MoonshineAgency/joint/README.md

# Joint

Project of the MQTT controller based on the ESP32 for horticulture applications.
Contains firmware and KiCad projects for controllers.
