MoonshineAgency/joint/hardware/pH-meter/ph_meter.kicad_pcb

## KiCad design hardware/pH-meter/ph_meter.kicad_pcb (2023-06-20)

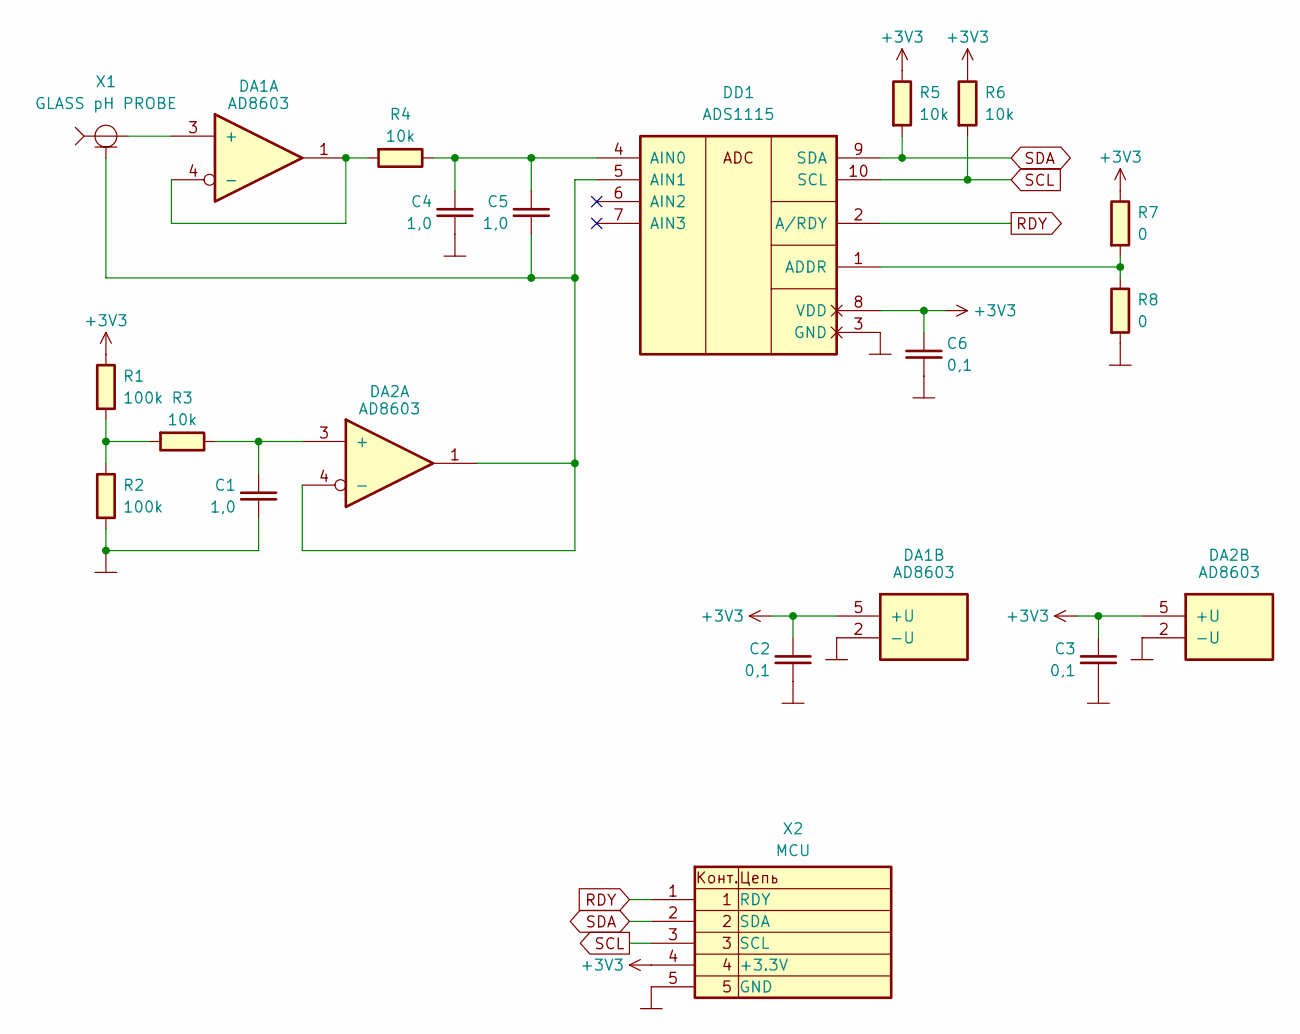
[picture p2: schematic ph_meter.kicad_sch, Digital pH sensor]

Parts:
C1, C4, C5: 1,0; C_0805_2012Metric_Pad1.18x1.45mm_HandSolder
C2, C3, C6: 0,1; C_0805_2012Metric_Pad1.18x1.45mm_HandSolder
DA1, DA2: AD8603; TSOT-23-5_HandSoldering
DD1: ADS1115; MSOP-10_3x3mm_P0.5mm
R1, R2: 100k; R_0805_2012Metric_Pad1.20x1.40mm_HandSolder
R3, R4, R5, R6: 10k; R_0805_2012Metric_Pad1.20x1.40mm_HandSolder
R7, R8: 0; R_0805_2012Metric_Pad1.20x1.40mm_HandSolder
X1: GLASS pH PROBE; BNC_Amphenol_B6252HB-NPP3G-50_Horizontal
X2: MCU; PinHeader_1x05_P2.54mm_Vertical

Connections:
+3V3: C2.2, C3.2, C6.2, DA1.5 (+U), DA2.5 (+U), DD1.8 (VDD), R1.2 (R), R5.2 (R), R6.2 (R), R7.2 (R), X2.4
GND: C1.1, C2.1, C3.1, C4.1, C6.1, DA1.2 (-U), DA2.2 (-U), DD1.3 (GND), R2.1 (L), R8.1 (L), X2.5
unnamed: DA1.3 (+), X1.1
unnamed: DA1.1, DA1.4 (-), R4.1 (L)
unnamed: C1.2, DA2.3 (+), R3.2 (R)
unnamed: C5.1, DA2.1, DA2.4 (-), DD1.5 (AIN1), X1.2
unnamed: DD1.1 (ADDR), R7.1 (L), R8.2 (R)
unnamed: C4.2, C5.2, DD1.4 (AIN0), R4.2 (R)
unnamed: R1.1 (L), R2.2 (R), R3.1 (L)
RDY: DD1.2 (A/RDY), X2.1
SCL: DD1.10 (SCL), R6.1 (L), X2.3
SDA: DD1.9 (SDA), R5.1 (L), X2.2

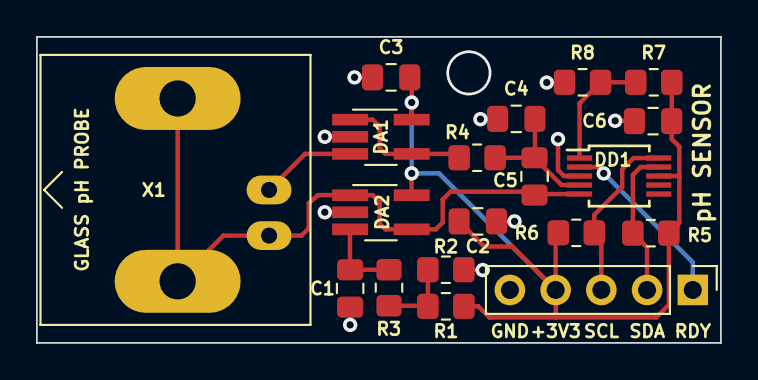
[picture p3: board ph_meter.kicad_pcb from above]

Board: 2 copper layers, 38.0 x 17.0 mm, 19 parts (0 on the bottom side), 12 nets.
