MoonshineAgency/joint/hardware/GH-4DEV/greenhouse.kicad_pcb

## KiCad design hardware/GH-4DEV/greenhouse.kicad_pcb (2023-06-20)

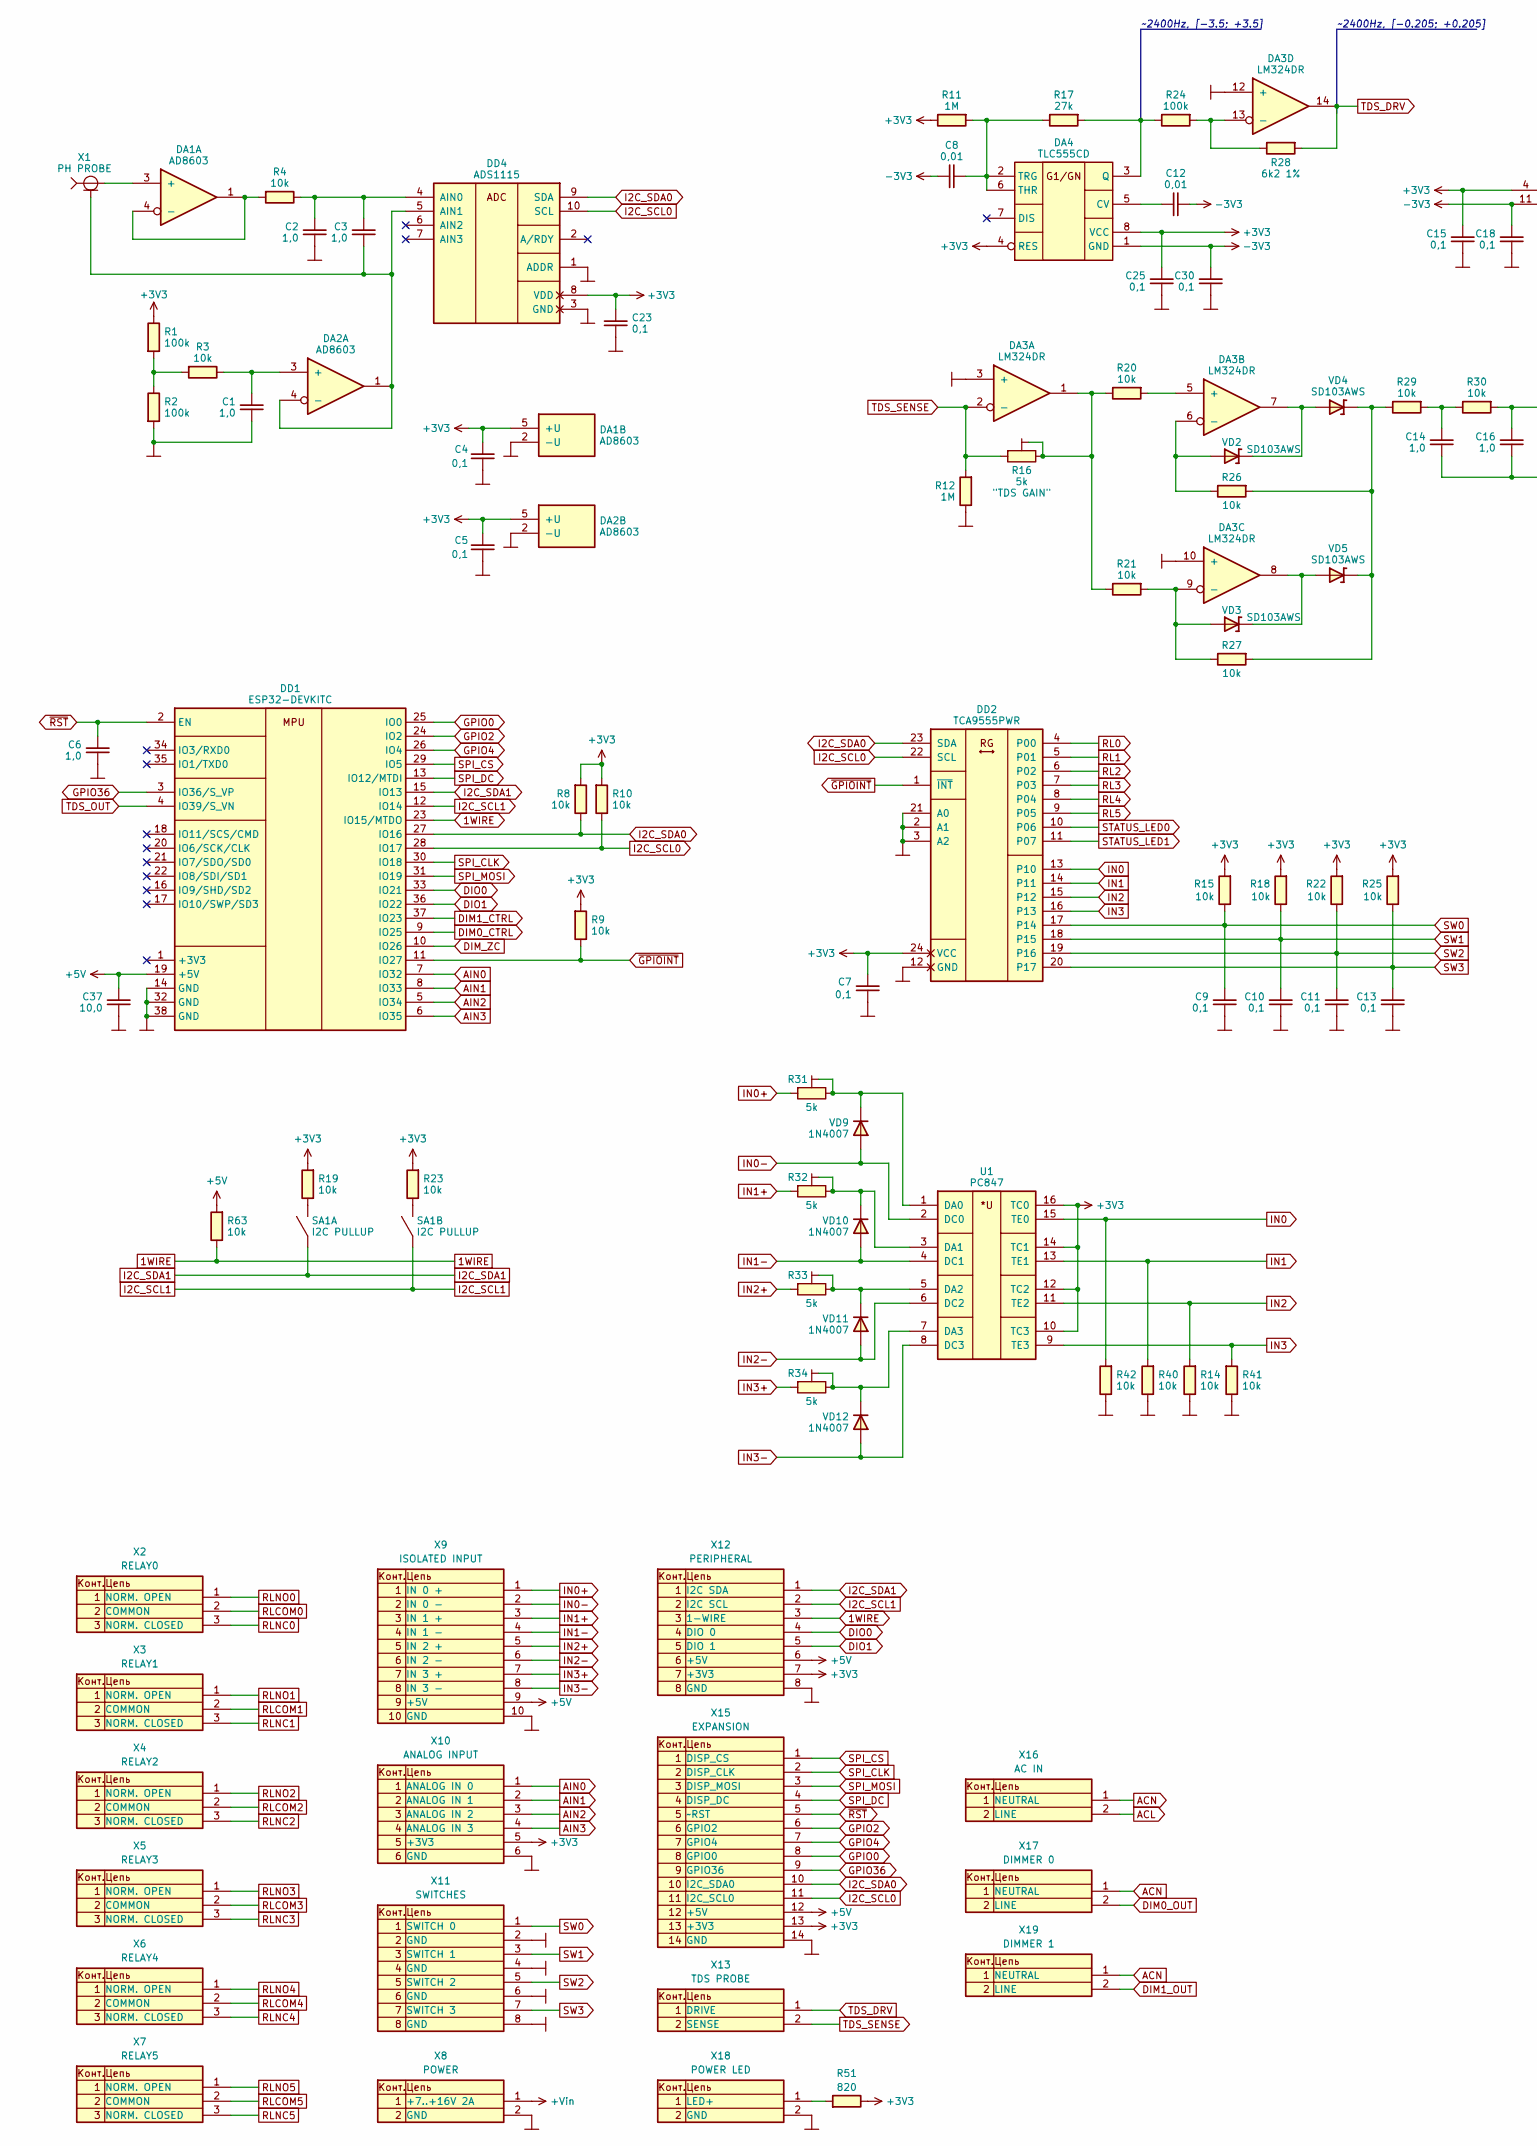
[picture p4: schematic greenhouse.kicad_sch, Greenhouse Controller, part in row 1, column 1]

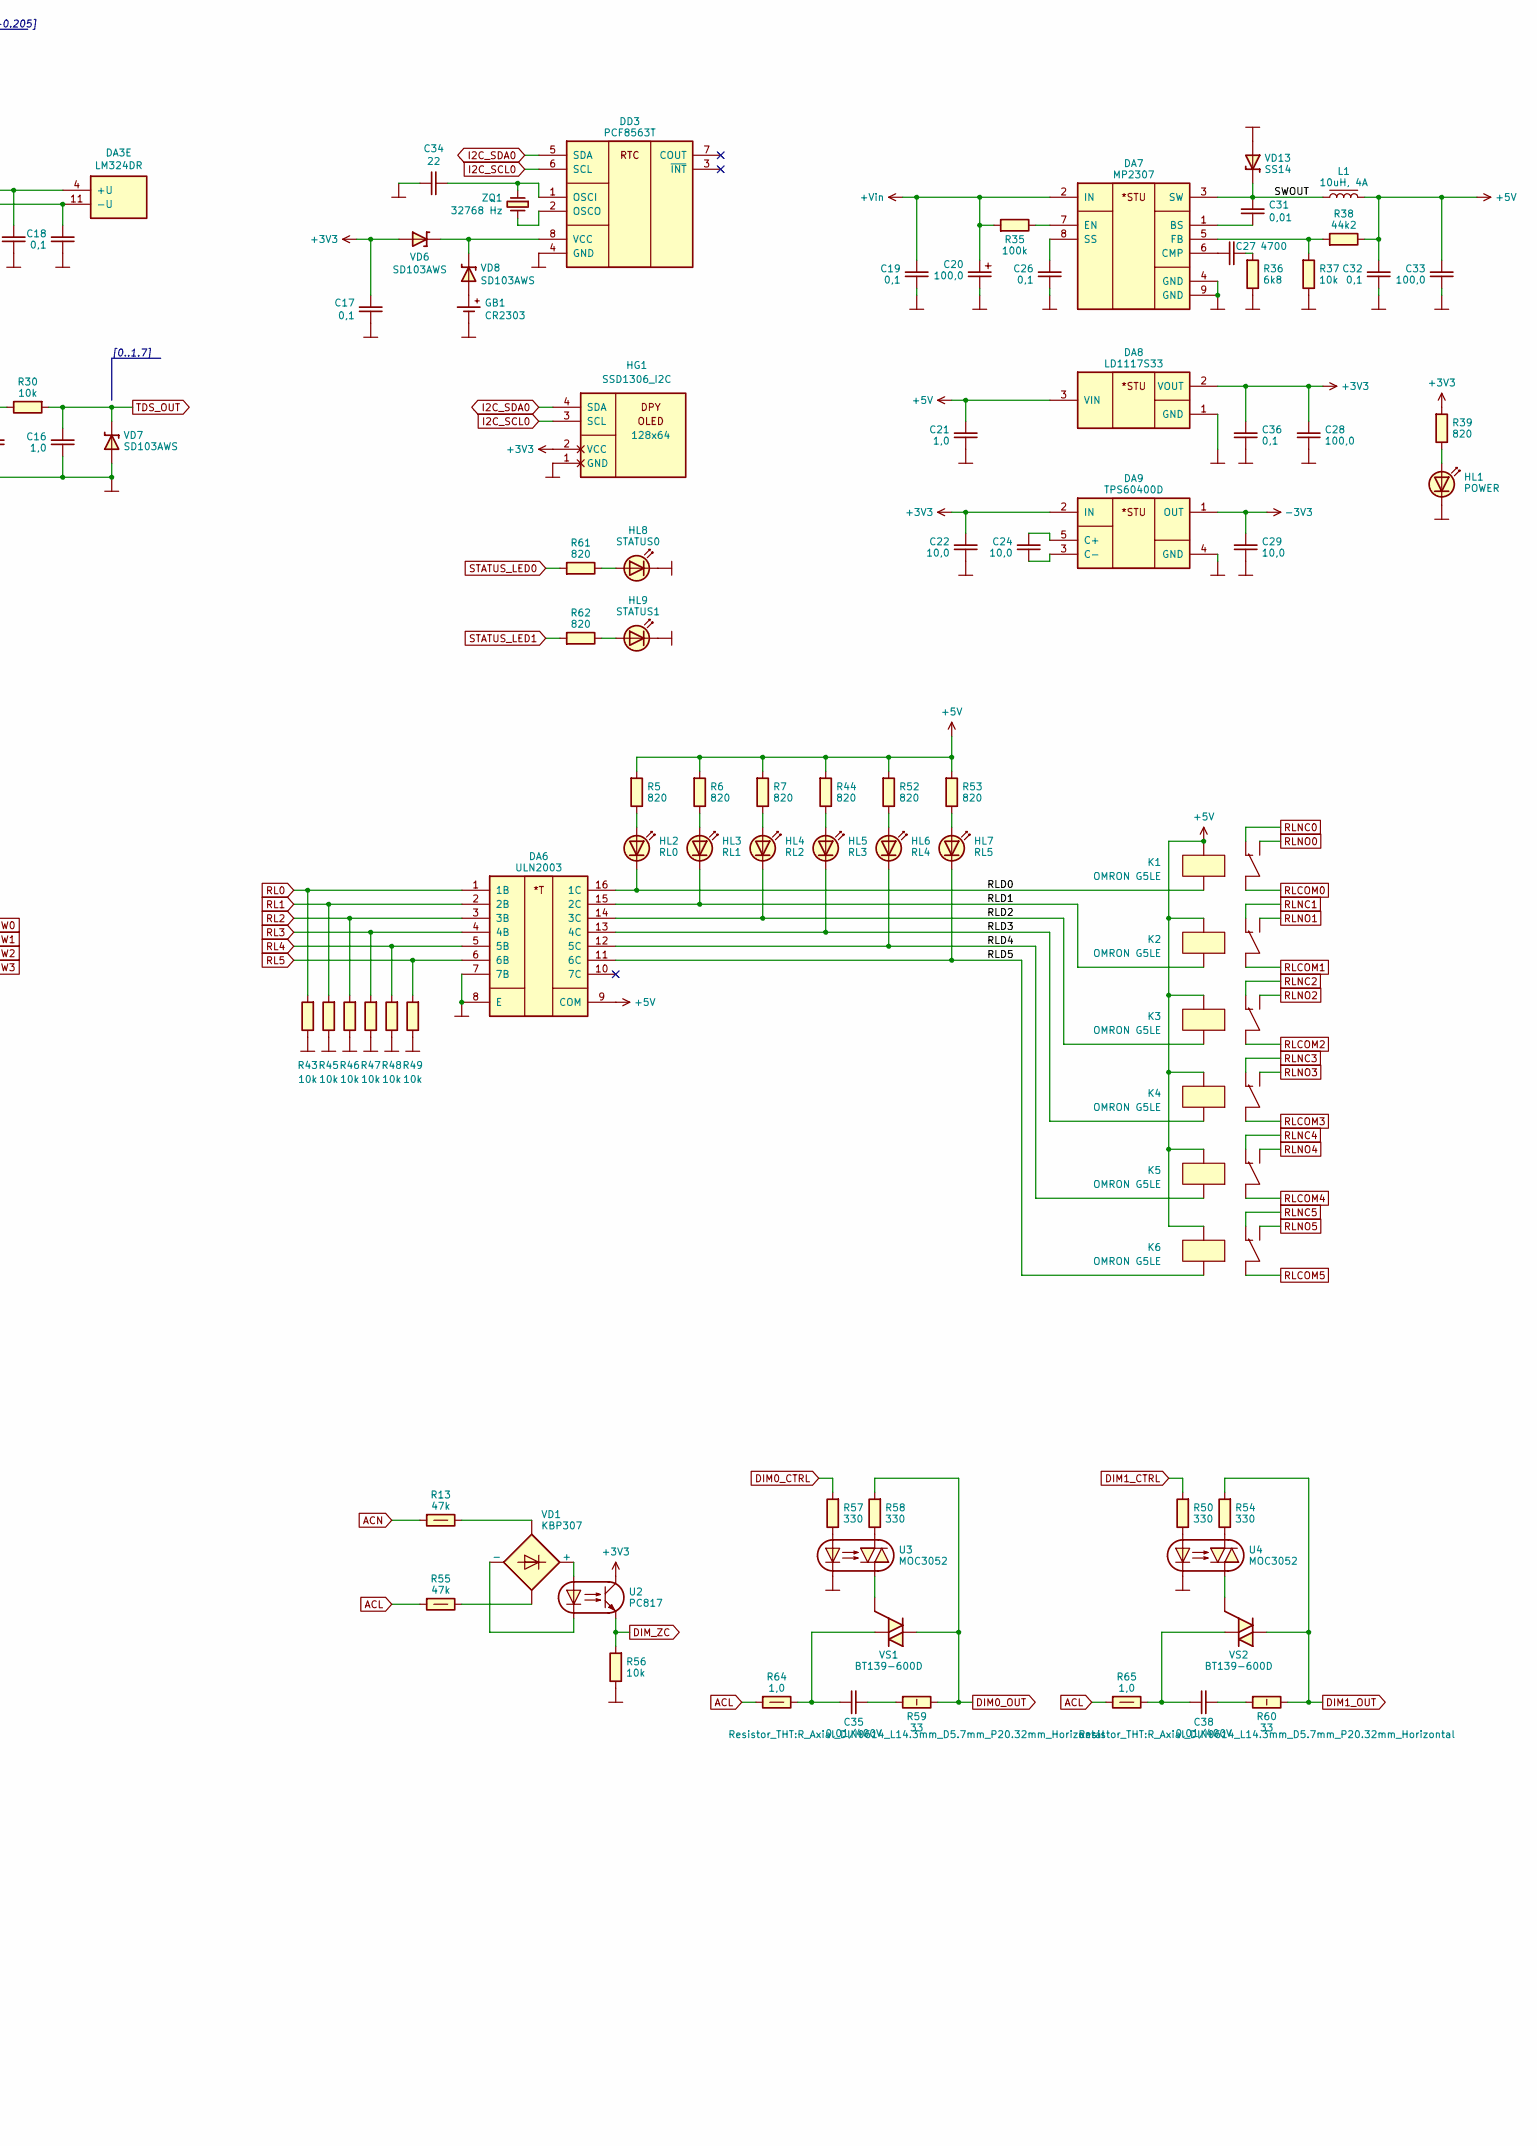
[picture p5: schematic greenhouse.kicad_sch, Greenhouse Controller, part in row 1, column 2]

Parts:
C1, C2, C3, C6, C14, C16, C21: 1,0; C_0805_2012Metric_Pad1.18x1.45mm_HandSolder
C4, C5, C7, C9, C10, C11, C13, C15, C17, C18, C19, C23, C25, C26, C30, C32, C36: 0,1; C_0805_2012Metric_Pad1.18x1.45mm_HandSolder
C8, C12, C31: 0,01; C_0805_2012Metric_Pad1.18x1.45mm_HandSolder
C20: 100,0; CP_EIA-7343-31_Kemet-D_Pad2.25x2.55mm_HandSolder
C22, C24, C29, C37: 10,0; C_0805_2012Metric_Pad1.18x1.45mm_HandSolder
C27: 4700; C_0805_2012Metric_Pad1.18x1.45mm_HandSolder
C28, C33: 100,0; C_1210_3225Metric_Pad1.33x2.70mm_HandSolder
C34: 22; C_0805_2012Metric_Pad1.18x1.45mm_HandSolder
C35, C38: 0,01/400V; C_Rect_L13.0mm_W5.0mm_P10.00mm_FKS3_FKP3_MKS4
DA1, DA2: AD8603; TSOT-23-5_HandSoldering
DA3: LM324DR; SOIC-14_3.9x8.7mm_P1.27mm
DA4: TLC555CD; SOIC-8_3.9x4.9mm_P1.27mm
DA6: ULN2003; SOIC-16_3.9x9.9mm_P1.27mm
DA7: MP2307; HSOP-8-1EP_3.9x4.9mm_P1.27mm_EP2.41x3.1mm_ThermalVias
DA8: LD1117S33; SOT-223-3_TabPin2
DA9: TPS60400D; SOT-23-5_HandSoldering
DD1: ESP32-DEVKITC
DD2: TCA9555PWR; TSSOP-24_4.4x7.8mm_P0.65mm
DD3: PCF8563T; SOIC-8_3.9x4.9mm_P1.27mm
DD4: ADS1115; MSOP-10_3x3mm_P0.5mm
GB1: CR2303; BAT_BS-7
HG1: SSD1306_I2C; SSD1306_0.96_Oled
HL1: POWER; LED_0805_2012Metric_Pad1.15x1.40mm_HandSolder
HL2: RL0; LED_0805_2012Metric_Pad1.15x1.40mm_HandSolder
HL3: RL1; LED_0805_2012Metric_Pad1.15x1.40mm_HandSolder
HL4: RL2; LED_0805_2012Metric_Pad1.15x1.40mm_HandSolder
HL5: RL3; LED_0805_2012Metric_Pad1.15x1.40mm_HandSolder
HL6: RL4; LED_0805_2012Metric_Pad1.15x1.40mm_HandSolder
HL7: RL5; LED_0805_2012Metric_Pad1.15x1.40mm_HandSolder
HL8: STATUS0; LED_0805_2012Metric_Pad1.15x1.40mm_HandSolder
HL9: STATUS1; LED_0805_2012Metric_Pad1.15x1.40mm_HandSolder
K1, K2, K3, K4, K5, K6: OMRON G5LE; Relay_SPDT_Omron-G5LE-1
L1: 10uH, 4A; L_0808
R1, R2, R24, R35: 100k; R_0805_2012Metric_Pad1.20x1.40mm_HandSolder
R3, R4, R8, R9, R10, R14, R15, R18, R19, R20, R21, R22, R23, R25, R26, R27, R29, R30, R37, R40, R41, R42, R43, R45, R46, R47, R48, R49, R56, R63: 10k; R_0805_2012Metric_Pad1.20x1.40mm_HandSolder
R5, R6, R7, R39, R44, R51, R52, R53, R61, R62: 820; R_0805_2012Metric_Pad1.20x1.40mm_HandSolder
R11, R12: 1M; R_0805_2012Metric_Pad1.20x1.40mm_HandSolder
R13, R55: 47k; R_Axial_DIN0309_L9.0mm_D3.2mm_P12.70mm_Horizontal
R16, R31, R32, R33, R34: 5k; Potentiometer_Bourns_3296W_Vertical
R17: 27k; R_0805_2012Metric_Pad1.20x1.40mm_HandSolder
R28: 6k2 1%; R_0805_2012Metric_Pad1.20x1.40mm_HandSolder
R36: 6k8; R_0805_2012Metric_Pad1.20x1.40mm_HandSolder
R38: 44k2; R_0805_2012Metric_Pad1.20x1.40mm_HandSolder
R50, R54, R57, R58: 330; R_0805_2012Metric_Pad1.20x1.40mm_HandSolder
R59, R60: 33; R_Axial_DIN0614_L14.3mm_D5.7mm_P20.32mm_Horizontal
R64, R65: 1,0; R_Axial_DIN0309_L9.0mm_D3.2mm_P2.54mm_Vertical
SA1: I2C PULLUP; SW_DIP_SPSTx02_Slide_6.7x6.64mm_W7.62mm_P2.54mm_LowProfile
U1: PC847; DIP-16_W7.62mm_LongPads
U2: PC817; DIP-4_W7.62mm_LongPads
U3, U4: MOC3052; DIP-6_W7.62mm_LongPads
VD1: KBP307; Diode_Bridge_Vishay_KBPM
VD2, VD3, VD4, VD5, VD6, VD7, VD8: SD103AWS; D_SOD-323_HandSoldering
VD9, VD10, VD11, VD12: 1N4007; D_SOD-123
VD13: SS14; D_SMA
VS1, VS2: BT139-600D; TO-220-3_Vertical
X1: PH PROBE; BNC_Amphenol_B6252HB-NPP3G-50_Horizontal
X2: RELAY0; TerminalBlock_bornier-3_P5.08mm
X3: RELAY1; TerminalBlock_bornier-3_P5.08mm
X4: RELAY2; TerminalBlock_bornier-3_P5.08mm
X5: RELAY3; TerminalBlock_bornier-3_P5.08mm
X6: RELAY4; TerminalBlock_bornier-3_P5.08mm
X7: RELAY5; TerminalBlock_bornier-3_P5.08mm
X8: POWER; TerminalBlock_bornier-2_P5.08mm
X9: ISOLATED INPUT; TerminalBlock_bornier-10_P5.08mm
X10: ANALOG INPUT; TerminalBlock_bornier-6_P5.08mm
X11: SWITCHES; TerminalBlock_bornier-8_P5.08mm
X12: PERIPHERAL; TerminalBlock_bornier-8_P5.08mm
X13: TDS PROBE; TerminalBlock_bornier-2_P5.08mm
X15: EXPANSION; PinHeader_2x07_P2.54mm_Vertical
X16: AC IN; TerminalBlock_bornier-2_P5.08mm
X17: DIMMER 0; TerminalBlock_bornier-2_P5.08mm
X18: POWER LED; PinHeader_1x02_P2.54mm_Vertical
X19: DIMMER 1; TerminalBlock_bornier-2_P5.08mm
ZQ1: 32768 Hz; Crystal_DS26_D2.0mm_L6.0mm_Horizontal

Connections:
1WIRE: DD1.23 (IO15/MTDO), R63.2 (R), X12.3
+3V3: C4.1, C5.1, C7.1, C15.1, C17.1, C22.1, C23.2, C25.1, C28.1, C36.1, DA1.5 (+U), DA2.5 (+U), DA3.4 (+U), DA4.4 (RES), DA4.8 (VCC), DA8.2 (VOUT), DA9.2 (IN), DD2.24 (VCC), DD4.8 (VDD), HG1.2 (VCC), R1.2 (R), R8.1 (L), R9.1 (L), R10.1 (L), R11.2 (R), R15.1 (L), R18.1 (L), R19.1 (L), R22.1 (L), R23.1 (L), R25.1 (L), R39.1 (L), R51.2 (R), U1.10 (TC3), U1.12 (TC2), U1.14 (TC1), U1.16 (TC0), U2.4, VD6.2 (A), X10.5, X12.7, X15.13
+5V: C21.1, C32.1, C33.1, C37.1, DA6.9 (COM), DA8.3 (VIN), DD1.19 (+5V), K1.2, K2.2, K3.2, K4.2, K5.2, K6.2, L1.2, R5.1 (L), R6.1 (L), R7.1 (L), R38.2 (R), R44.1 (L), R52.1 (L), R53.1 (L), R63.1 (L), X9.9, X12.6, X15.12
+Vin: C19.1, C20.1, DA7.2 (IN), R35.1 (L), X8.1
-3V3: C8.2, C12.1, C18.1, C29.1, C30.1, DA3.11 (-U), DA4.1 (GND), DA9.1 (OUT)
/RLD0: DA6.16 (1C), HL2.1 (K), K1.5
/RLD1: DA6.15 (2C), HL3.1 (K), K2.5
/RLD2: DA6.14 (3C), HL4.1 (K), K3.5
/RLD3: DA6.13 (4C), HL5.1 (K), K4.5
/RLD4: DA6.12 (5C), HL6.1 (K), K5.5
/RLD5: DA6.11 (6C), HL7.1 (K), K6.5
/SWOUT: C31.1, DA7.3 (SW), L1.1, VD13.1 (K)
ACL: R55.1 (L), R64.1 (L), R65.1 (L), X16.2
ACN: R13.1 (L), X16.1, X17.1, X19.1
AIN0: DD1.7 (IO32), X10.1
AIN1: DD1.8 (IO33), X10.2
AIN2: DD1.5 (IO34), X10.3
AIN3: DD1.6 (IO35), X10.4
DIM0_CTRL: DD1.9 (IO25), R57.1 (L)
DIM0_OUT: R58.1 (L), R59.2 (R), VS1.2 (A), X17.2
DIM1_CTRL: DD1.37 (IO23), R50.1 (L)
DIM1_OUT: R54.1 (L), R60.2 (R), VS2.2 (A), X19.2
DIM_ZC: DD1.10 (IO26), R56.1 (L), U2.3
DIO0: DD1.33 (IO21), X12.4
DIO1: DD1.36 (IO22), X12.5
GND: C1.1, C2.1, C4.2, C5.2, C6.2, C7.2, C9.2, C10.2, C11.2, C13.2, C14.2, C15.2, C16.2, C17.2, C18.2, C19.2, C20.2, C21.2, C22.2, C23.1, C25.2, C26.2, C28.2, C29.2, C30.2, C32.2, C33.2, C34.2, C36.2, C37.2, DA1.2 (-U), DA2.2 (-U), DA3.3 (+), DA3.10 (+), DA3.12 (+), DA6.7 (7B), DA6.8 (E), DA7.4 (GND), DA7.9 (GND), DA8.1 (GND), DA9.4 (GND), DD1.14 (GND), DD1.32 (GND), DD1.38 (GND), DD2.2 (A1), DD2.3 (A2), DD2.12 (GND), DD2.21 (A0), DD3.4 (GND), DD4.1 (ADDR), DD4.3 (GND), GB1.2, HG1.1 (GND), HL1.1 (K), HL8.1 (K), HL9.1 (K), R2.1 (L), R12.2 (R), R14.2 (R), R36.2 (R), R37.2 (R), R40.2 (R), R41.2 (R), R42.2 (R), R43.2 (R), R45.2 (R), R46.2 (R), R47.2 (R), R48.2 (R), R49.2 (R), R56.2 (R), U3.2, U4.2, VD7.2 (A), VD13.2 (A), X8.2, X9.10, X10.6, X11.2, X11.4, X11.6, X11.8, X12.8, X15.14, X18.2
GPIO0: DD1.25 (IO0), X15.8
GPIO2: DD1.24 (IO2), X15.6
GPIO4: DD1.26 (IO4), X15.7
GPIO36: DD1.3 (IO36/S_VP), X15.9
I2C_SCL0: DD1.28 (IO17), DD2.22 (SCL), DD3.6 (SCL), DD4.10 (SCL), HG1.3 (SCL), R10.2 (R), X15.11
I2C_SCL1: DD1.12 (IO14), SA1.2 (L), X12.2
I2C_SDA0: DD1.27 (IO16), DD2.23 (SDA), DD3.5 (SDA), DD4.9 (SDA), HG1.4 (SDA), R8.2 (R), X15.10
I2C_SDA1: DD1.15 (IO13), SA1.1 (L), X12.1
IN0: DD2.13 (P10), R42.1 (L), U1.15 (TE0)
IN0+: R31.1, X9.1
IN0-: U1.2 (DC0), VD9.2 (A), X9.2
IN1: DD2.14 (P11), R40.1 (L), U1.13 (TE1)
IN1+: R32.1, X9.3
IN1-: U1.4 (DC1), VD10.2 (A), X9.4
IN2: DD2.15 (P12), R14.1 (L), U1.11 (TE2)
IN2+: R33.1, X9.5
IN2-: U1.6 (DC2), VD11.2 (A), X9.6
IN3: DD2.16 (P13), R41.1 (L), U1.9 (TE3)
IN3+: R34.1, X9.7
IN3-: U1.8 (DC3), VD12.2 (A), X9.8
unnamed: DA1.3 (+), X1.1
unnamed: DA1.1, DA1.4 (-), R4.1 (L)
unnamed: C1.2, DA2.3 (+), R3.2 (R)
unnamed: C3.1, DA2.1, DA2.4 (-), DD4.5 (AIN1), X1.2
unnamed: DA3.5 (+), R20.1 (L)
unnamed: DA3.6 (-), R26.2 (R), VD2.2 (A)
unnamed: DA3.9 (-), R21.1 (L), R27.2 (R), VD3.2 (A)
unnamed: DA3.13 (-), R24.1 (L), R28.2 (R)
unnamed: C12.2, DA4.5 (CV)
unnamed: DA4.3 (Q), R17.1 (L), R24.2 (R)
unnamed: C8.1, DA4.2 (TRG), DA4.6 (THR), R11.1 (L), R17.2 (R)
unnamed: C31.2, DA7.1 (BS)
unnamed: C27.2, DA7.6 (CMP)
unnamed: DA7.7 (EN), R35.2 (R)
unnamed: DA7.5 (FB), R37.1 (L), R38.1 (L)
unnamed: C26.1, DA7.8 (SS)
unnamed: C24.1, DA9.5 (C+)
unnamed: C24.2, DA9.3 (C-)
unnamed: C34.1, DD3.1 (OSCI), ZQ1.1
unnamed: DD3.2 (OSCO), ZQ1.2
unnamed: DD3.8 (VCC), VD6.1 (K), VD8.1 (K)
unnamed: C2.2, C3.2, DD4.4 (AIN0), R4.2 (R)
unnamed: HL1.2 (A), R39.2 (R)
unnamed: HL2.2 (A), R5.2 (R)
unnamed: HL3.2 (A), R6.2 (R)
unnamed: HL4.2 (A), R7.2 (R)
unnamed: HL5.2 (A), R44.2 (R)
unnamed: HL6.2 (A), R52.2 (R)
unnamed: HL7.2 (A), R53.2 (R)
unnamed: HL8.2 (A), R61.2 (R)
unnamed: HL9.2 (A), R62.2 (R)
unnamed: R1.1 (L), R2.2 (R), R3.1 (L)
unnamed: R13.2 (R), VD1.2
unnamed: R19.2 (R), SA1.4 (R)
unnamed: DA3.1, R16.2, R16.3, R20.2 (R), R21.2 (R)
unnamed: R23.2 (R), SA1.3 (R)
unnamed: R26.1 (L), R27.1 (L), R29.2 (R), VD4.1 (K), VD5.1 (K)
unnamed: C14.1, R29.1 (L), R30.2 (R)
unnamed: C27.1, R36.1 (L)
unnamed: R50.2 (R), U4.1
unnamed: R51.1 (L), X18.1
unnamed: R54.2 (R), U4.6
unnamed: R55.2 (R), VD1.3
unnamed: R57.2 (R), U3.1
unnamed: R58.2 (R), U3.6
unnamed: C35.2, R59.1 (L)
unnamed: C38.2, R60.1 (L)
unnamed: C35.1, R64.2 (R), VS1.1 (K)
unnamed: C38.1, R65.2 (R), VS2.1 (K)
unnamed: R31.2, R31.3, U1.1 (DA0), VD9.1 (K)
unnamed: R32.2, R32.3, U1.3 (DA1), VD10.1 (K)
unnamed: R33.2, R33.3, U1.5 (DA2), VD11.1 (K)
unnamed: R34.2, R34.3, U1.7 (DA3), VD12.1 (K)
unnamed: U2.1, VD1.1 (+)
unnamed: U2.2, VD1.4 (-)
unnamed: DA3.7, VD2.1 (K), VD4.2 (A)
unnamed: DA3.8, VD3.1 (K), VD5.2 (A)
unnamed: GB1.1, VD8.2 (A)
unnamed: U3.4, VS1.3 (G)
unnamed: U4.4, VS2.3 (G)
RL0: DA6.1 (1B), DD2.4 (P00), R43.1 (L)
RL1: DA6.2 (2B), DD2.5 (P01), R45.1 (L)
RL2: DA6.3 (3B), DD2.6 (P02), R46.1 (L)
RL3: DA6.4 (4B), DD2.7 (P03), R47.1 (L)
RL4: DA6.5 (5B), DD2.8 (P04), R48.1 (L)
RL5: DA6.6 (6B), DD2.9 (P05), R49.1 (L)
RLCOM0: K1.1, X2.2
RLCOM1: K2.1, X3.2
RLCOM2: K3.1, X4.2
RLCOM3: K4.1, X5.2
RLCOM4: K5.1, X6.2
RLCOM5: K6.1, X7.2
RLNC0: K1.4, X2.3
RLNC1: K2.4, X3.3
RLNC2: K3.4, X4.3
RLNC3: K4.4, X5.3
RLNC4: K5.4, X6.3
RLNC5: K6.4, X7.3
RLNO0: K1.3, X2.1
RLNO1: K2.3, X3.1
RLNO2: K3.3, X4.1
RLNO3: K4.3, X5.1
RLNO4: K5.3, X6.1
RLNO5: K6.3, X7.1
SPI_CLK: DD1.30 (IO18), X15.2
SPI_CS: DD1.29 (IO5), X15.1
SPI_DC: DD1.13 (IO12/MTDI), X15.4
SPI_MOSI: DD1.31 (IO19), X15.3
STATUS_LED0: DD2.10 (P06), R61.1 (L)
STATUS_LED1: DD2.11 (P07), R62.1 (L)
SW0: C9.1, DD2.17 (P14), R15.2 (R), X11.1
SW1: C10.1, DD2.18 (P15), R18.2 (R), X11.3
SW2: C11.1, DD2.19 (P16), R22.2 (R), X11.5
SW3: C13.1, DD2.20 (P17), R25.2 (R), X11.7
TDS_DRV: DA3.14, R28.1 (L), X13.1
TDS_OUT: C16.1, DD1.4 (IO39/S_VN), R30.1 (L), VD7.1 (K)
TDS_SENSE: DA3.2 (-), R12.1 (L), R16.1, X13.2
~GPIOINT: DD1.11 (IO27), DD2.1 (~INT), R9.2 (R)
~RST: C6.1, DD1.2 (EN), X15.5

Notes on the sheet:
~2400Hz, [-3.5; +3.5]
~2400Hz, [-0.205; +0.205]
[0..1.7]

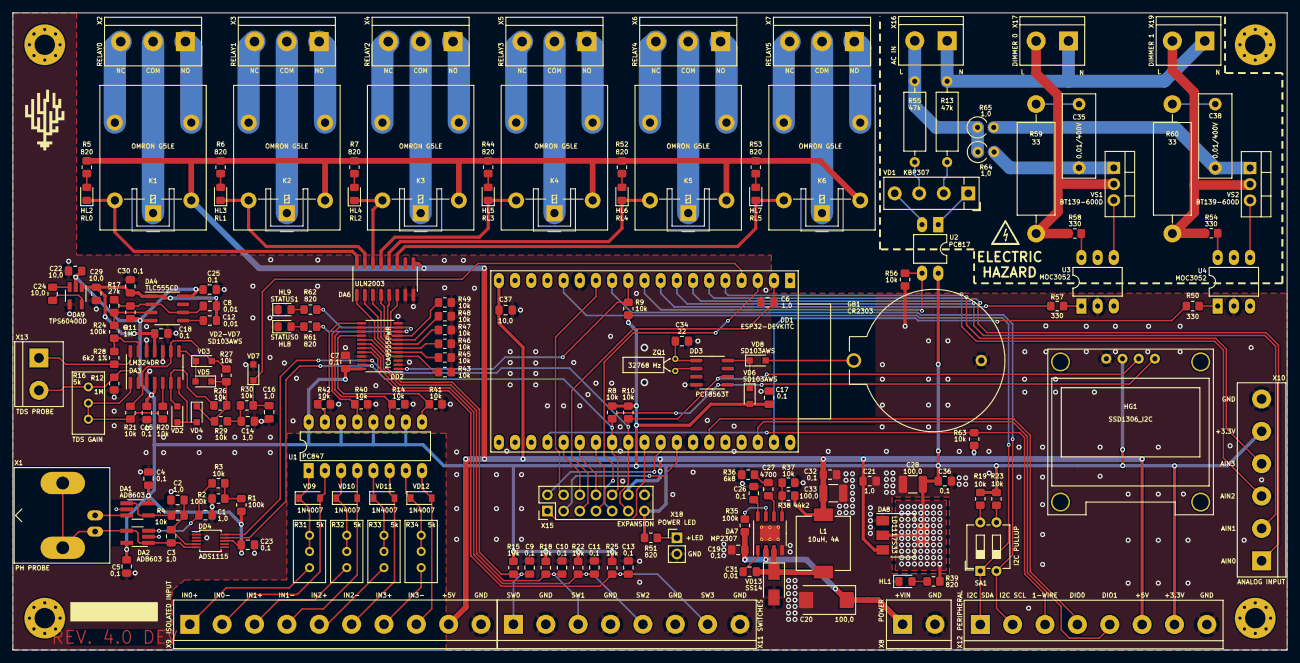
[picture p6: board greenhouse.kicad_pcb from above]

Board: 2 copper layers, 200.0 x 100.0 mm, 176 parts (0 on the bottom side), 145 nets.

Other parts of the board:
XS1, XS2, XS3, XS4: M3 3.2mm; MountingHole_3.2mm_M3_Pad_Via
