MoonshineAgency/joint/hardware/TDS-meter/tds_meter.kicad_pcb

## KiCad design hardware/TDS-meter/tds_meter.kicad_pcb (2023-06-12)

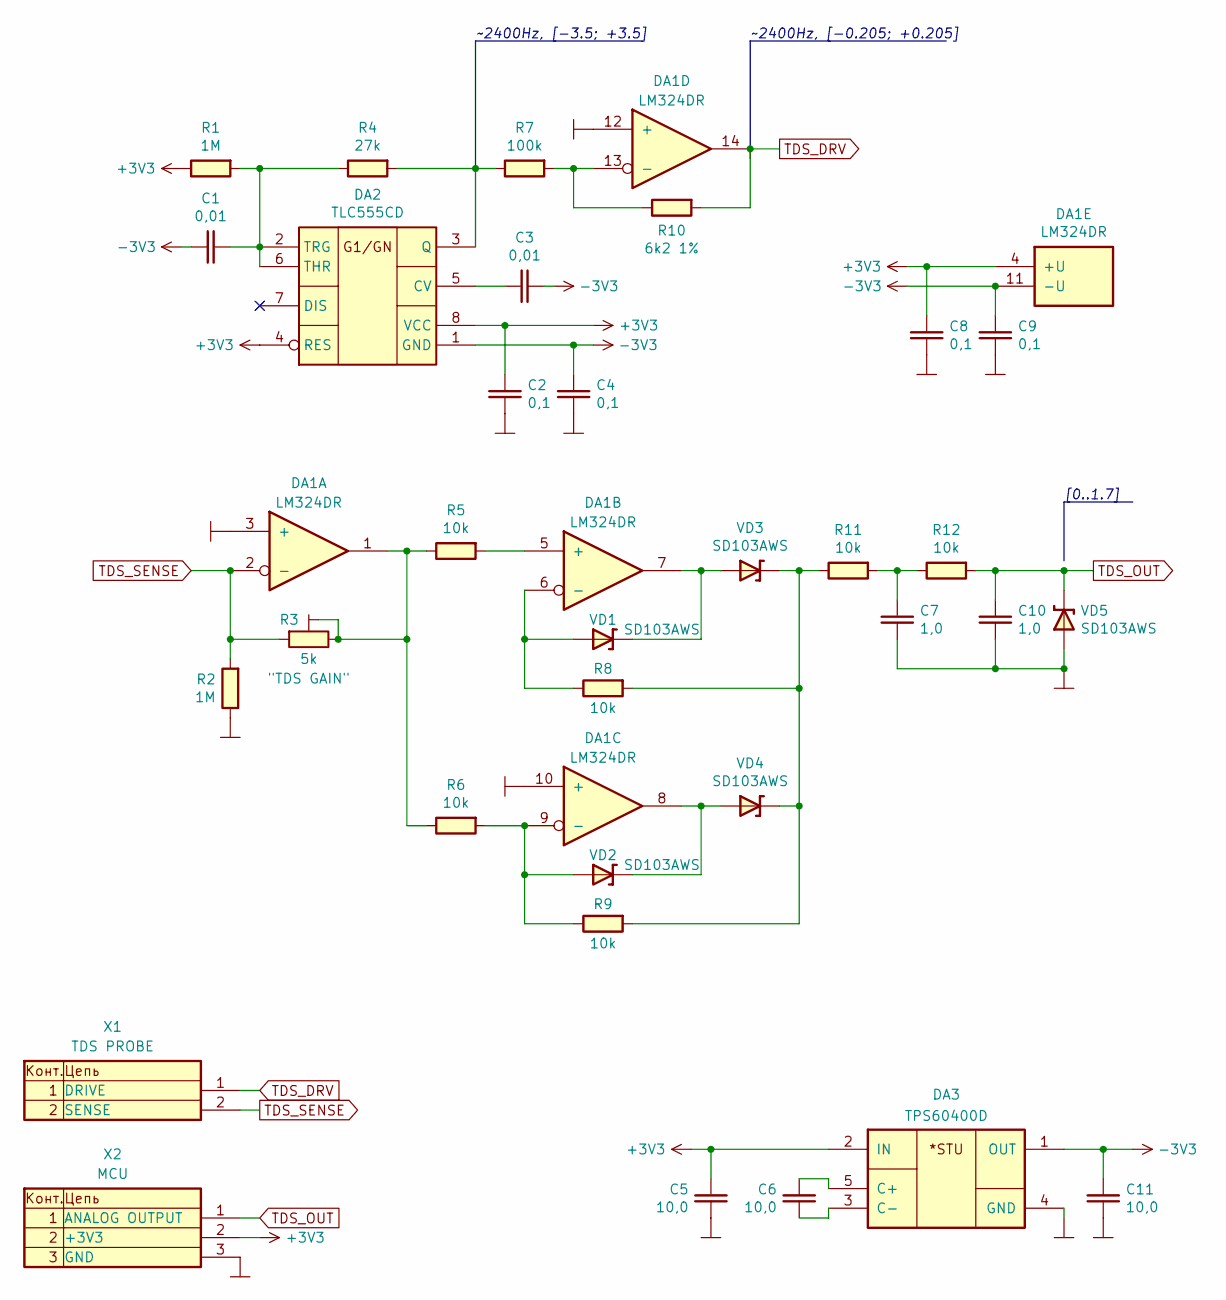
[picture p7: schematic tds_meter.kicad_sch, TDS Meter]

Parts:
C1, C3: 0,01; C_0805_2012Metric_Pad1.18x1.45mm_HandSolder
C2, C4, C8, C9: 0,1; C_0805_2012Metric_Pad1.18x1.45mm_HandSolder
C5, C6, C11: 10,0; C_0805_2012Metric_Pad1.18x1.45mm_HandSolder
C7, C10: 1,0; C_0805_2012Metric_Pad1.18x1.45mm_HandSolder
DA1: LM324DR; SOIC-14_3.9x8.7mm_P1.27mm
DA2: TLC555CD; SOIC-8_3.9x4.9mm_P1.27mm
DA3: TPS60400D; SOT-23-5_HandSoldering
R1, R2: 1M; R_0805_2012Metric_Pad1.20x1.40mm_HandSolder
R3: 5k; Potentiometer_Bourns_3296W_Vertical
R4: 27k; R_0805_2012Metric_Pad1.20x1.40mm_HandSolder
R5, R6, R8, R9, R11, R12: 10k; R_0805_2012Metric_Pad1.20x1.40mm_HandSolder
R7: 100k; R_0805_2012Metric_Pad1.20x1.40mm_HandSolder
R10: 6k2 1%; R_0805_2012Metric_Pad1.20x1.40mm_HandSolder
VD1, VD2, VD3, VD4, VD5: SD103AWS; D_SOD-323_HandSoldering
X1: TDS PROBE; TerminalBlock_bornier-2_P5.08mm
X2: MCU; PinHeader_1x03_P2.54mm_Vertical

Connections:
+3V3: C2.1, C5.1, C8.1, DA1.4 (+U), DA2.4 (RES), DA2.8 (VCC), DA3.2 (IN), R1.2 (R), X2.2
-3V3: C1.2, C3.1, C4.1, C9.1, C11.1, DA1.11 (-U), DA2.1 (GND), DA3.1 (OUT)
GND: C2.2, C4.2, C5.2, C7.2, C8.2, C9.2, C10.2, C11.2, DA1.3 (+), DA1.10 (+), DA1.12 (+), DA3.4 (GND), R2.2 (R), VD5.2 (A), X2.3
unnamed: DA1.5 (+), R5.1 (L)
unnamed: DA1.6 (-), R8.2 (R), VD1.2 (A)
unnamed: DA1.9 (-), R6.1 (L), R9.2 (R), VD2.2 (A)
unnamed: DA1.13 (-), R7.1 (L), R10.2 (R)
unnamed: C3.2, DA2.5 (CV)
unnamed: DA2.3 (Q), R4.1 (L), R7.2 (R)
unnamed: C1.1, DA2.2 (TRG), DA2.6 (THR), R1.1 (L), R4.2 (R)
unnamed: C6.1, DA3.5 (C+)
unnamed: C6.2, DA3.3 (C-)
unnamed: DA1.1, R3.2, R3.3, R5.2 (R), R6.2 (R)
unnamed: C7.1, R11.1 (L), R12.2 (R)
unnamed: R8.1 (L), R9.1 (L), R11.2 (R), VD3.1 (K), VD4.1 (K)
unnamed: DA1.7, VD1.1 (K), VD3.2 (A)
unnamed: DA1.8, VD2.1 (K), VD4.2 (A)
TDS_DRV: DA1.14, R10.1 (L), X1.1
TDS_OUT: C10.1, R12.1 (L), VD5.1 (K), X2.1
TDS_SENSE: DA1.2 (-), R2.1 (L), R3.1, X1.2

Notes on the sheet:
~2400Hz, [-3.5; +3.5]
~2400Hz, [-0.205; +0.205]
[0..1.7]

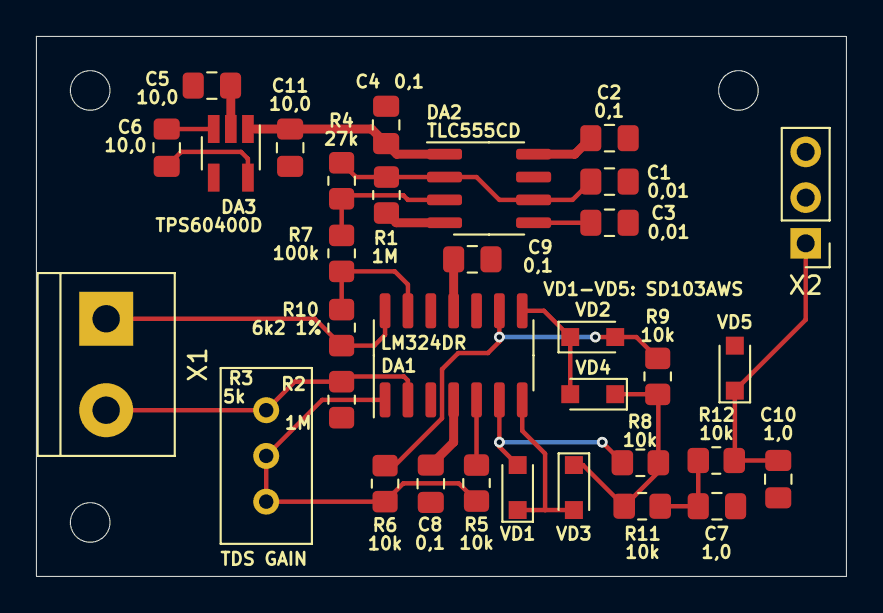
[picture p8: board tds_meter.kicad_pcb from above]

Board: 2 copper layers, 45.0 x 30.0 mm, 33 parts (0 on the bottom side), 20 nets.
