MoonshineAgency/joint/main/std_strings.h

#ifndef JOINT_DRV_STD_STRINGS_H_
#define JOINT_DRV_STD_STRINGS_H_

// JSON options
#define OPT_PERIOD               "period"
#define OPT_SENSORS              "sensors"
#define OPT_ADDRESS              "address"
#define OPT_FREQ                 "frequency"
#define OPT_TYPE                 "type"
#define OPT_GPIO                 "gpio"
#define OPT_PULLUP               "pullup"
#define OPT_SAMPLES              "samples"
#define OPT_MOISTURE             "moisture"
#define OPT_ENABLED              "enabled"
#define OPT_ATTEN                "attenuation"
#define OPT_CALIBRATION          "calibration"
#define OPT_PH                   "ph"
#define OPT_VOLTAGE              "voltage"
#define OPT_TDS_CALIBRATION      "tds_calibration"
#define OPT_MOISTURE_CALIBRATION "moisture_calibration"
#define OPT_TDS                  "tds"
#define OPT_VALUE                "value"


// device classes
#define DEV_CLASS_HUMIDITY    "humidity"
#define DEV_CLASS_TEMPERATURE "temperature"
#define DEV_CLASS_VOLTAGE     "voltage"
#define DEV_CLASS_PH          "ph"
#define DEV_CLASS_MOISTURE    "moisture"

// measurement units
#define DEV_MU_HUMIDITY    "%"
#define DEV_MU_TEMPERATURE "°C"
#define DEV_MU_VOLTAGE     "V"
#define DEV_MU_MOISTURE    "%"
#define DEV_MU_TDS         "mg/L"

#endif // JOINT_DRV_STD_STRINGS_H_
