MoonshineAgency/joint/main/drivers/drv_aht.c

#include "drv_aht.h"
#include "common.h"
#include "driver.h"
#include "settings.h"
#include <aht.h>

static cvector_vector_type(aht_t) sensors;

static esp_err_t on_init(driver_t *self)
{
    cvector_free(self->devices);
    cvector_free(sensors);

    // Init devices
    cJSON *sensors_j = cJSON_GetObjectItem(self->config, "sensors");
    for (int i = 0; i < cJSON_GetArraySize(sensors_j); i++)
    {
        cJSON *sensor_j = cJSON_GetArrayItem(sensors_j, i);
        gpio_num_t sda = driver_config_get_gpio(cJSON_GetObjectItem(sensor_j, "sda"), GPIO_NUM_NC);
        gpio_num_t scl = driver_config_get_gpio(cJSON_GetObjectItem(sensor_j, "scl"), GPIO_NUM_NC);
        i2c_port_t port = driver_config_get_int(cJSON_GetObjectItem(sensor_j, "port"), 1);
        uint8_t addr = driver_config_get_int(cJSON_GetObjectItem(sensor_j, "address"), AHT_I2C_ADDRESS_GND);
        int freq = driver_config_get_int(cJSON_GetObjectItem(sensor_j, "frequency"), 0);

        aht_t aht = { 0 };
        aht.type = driver_config_get_int(cJSON_GetObjectItem(sensor_j, "type"), 0);

        esp_err_t r = aht_init_desc(&aht, addr, port, sda, scl);
        if (r != ESP_OK)
        {
            ESP_LOGW(self->name, "Could not initialize descriptor for device %d: %d (%s)", i, r, esp_err_to_name(r));
            continue;
        }
        if (freq)
            aht.i2c_dev.cfg.master.clk_speed = freq;

        r = aht_init(&aht);
        if (r != ESP_OK)
        {
            ESP_LOGW(self->name, "Could not initialize device %d: %d (%s)", i, r, esp_err_to_name(r));
            aht_free_desc(&aht);
            continue;
        }
        cvector_push_back(sensors, aht);

        device_t dev = { 0 };
        snprintf(dev.uid, sizeof(dev.uid), "aht_rh%d", i);
        dev.type = DEV_SENSOR;
        snprintf(dev.name, sizeof(dev.name), "%s humidity (AHT sensor %d)", settings.node.name, i);
        strncpy(dev.device_class, "humidity", sizeof(dev.device_class));
        strncpy(dev.sensor.measurement_unit, "%", sizeof(dev.sensor.measurement_unit));
        dev.sensor.precision = 2;
        cvector_push_back(self->devices, dev);

        memset(&dev, 0, sizeof(device_t));
        snprintf(dev.uid, sizeof(dev.uid), "aht_t%d", i);
        dev.type = DEV_SENSOR;
        snprintf(dev.name, sizeof(dev.name), "%s temperature (AHT sensor %d)", settings.node.name, i);
        strncpy(dev.device_class, "temperature", sizeof(dev.device_class));
        strncpy(dev.sensor.measurement_unit, "°C", sizeof(dev.sensor.measurement_unit));
        dev.sensor.precision = 2;
        cvector_push_back(self->devices, dev);

        ESP_LOGI(self->name, "Initialized device %d: %s (ADDR=0x%02x, PORT=%d, SDA=%d, SCL=%d, FREQ=%dkHz)",
            i, aht.type == AHT_TYPE_AHT1x ? "AHT1x" : "AHT20", addr, port, sda, scl, aht.i2c_dev.cfg.master.clk_speed / 1000);
    }

    return ESP_OK;
}

static void task(driver_t *self)
{
    TickType_t period = pdMS_TO_TICKS(driver_config_get_int(cJSON_GetObjectItem(self->config, "period"), 1000));

    while (true)
    {
        TickType_t start = xTaskGetTickCount();

        for (size_t i = 0; i < cvector_size(sensors); i++)
        {
            float t = 0, rh = 0;
            esp_err_t r = aht_get_data(&sensors[i], &t, &rh);
            if (r != ESP_OK)
            {
                ESP_LOGW(self->name, "Error reading device %d: %d (%s)", i, r, esp_err_to_name(r));
                continue;
            }

            device_t *dev = &self->devices[i * 2];
            dev->sensor.value = rh;
            driver_send_device_update(self, dev);
            dev = &self->devices[i * 2 + 1];
            dev->sensor.value = t;
            driver_send_device_update(self, dev);
        }

        while (xTaskGetTickCount() - start < period)
        {
            if (!(xEventGroupGetBits(self->eg) & DRIVER_BIT_START))
                return;
            vTaskDelay(1);
        }
    }
}

static esp_err_t on_stop(driver_t *self)
{
    for (size_t i = 0; i < cvector_size(sensors); i++)
    {
        esp_err_t r = aht_free_desc(&sensors[i]);
        if (r != ESP_OK)
            ESP_LOGW(self->name, "Device descriptor free error %d: %d (%s)", i, r, esp_err_to_name(r));
    }

    return ESP_OK;
}

driver_t drv_aht = {
    .name = "drv_aht",
    .defconfig = "{ \"stack_size\": 4096, \"sensors\": [{ \"port\": 1, \"sda\": 13, \"scl\": 14, \"type\": 0 }] }",

    .config = NULL,
    .state = DRIVER_NEW,
    .event_queue = NULL,

    .devices = NULL,
    .handle = NULL,
    .eg = NULL,

    .on_init = on_init,
    .on_start = NULL,
    .on_stop = on_stop,

    .task = task
};
