MoonshineAgency/joint/main/common.c

#include "common.h"

const char *TAG = APP_NAME;
const char *SYSTEM_ID = NULL;

const char *DEVICE_MANUFACTURER = BOARD_MANUFACTURER;
const char *DEVICE_NAME = BOARD_NAME;
const char *DEVICE_MODEL = BOARD_MODEL;
