MoonshineAgency/joint/main/drivers/ds18b20.h

#ifndef ESP_IOT_NODE_PLUS_DRV_DC18X20_H_
#define ESP_IOT_NODE_PLUS_DRV_DC18X20_H_

#include "common.h"

#ifdef DRIVER_DS18B20

#include "driver.h"
#include "std_strings.h"

extern driver_t drv_ds18b20;

#endif

#endif // ESP_IOT_NODE_PLUS_DRV_DC18X20_H_
