MoonshineAgency/joint/main/drivers/gh_io.h

#ifndef ESP_IOT_NODE_PLUS_DRV_GH_IO_H_
#define ESP_IOT_NODE_PLUS_DRV_GH_IO_H_

#include "common.h"

#ifdef DRIVER_GH_IO

#include "driver.h"
#include "std_strings.h"

extern driver_t drv_gh_io;

#endif

#endif // ESP_IOT_NODE_PLUS_DRV_GH_IO_H_
