MoonshineAgency/joint/main/common.h

#ifndef ESP_IOT_NODE_PLUS_COMMON_H_
#define ESP_IOT_NODE_PLUS_COMMON_H_

#include <stddef.h>
#include <inttypes.h>
#include <stdlib.h>
#include <stdio.h>
#include <string.h>
#include <esp_log.h>
#include <esp_err.h>
#include <esp_check.h>
#include <freertos/FreeRTOS.h>
#include <freertos/task.h>
#include <freertos/queue.h>
#include <freertos/semphr.h>
#include <freertos/event_groups.h>

#include "config.h"

extern const char *TAG;
extern const char *SYSTEM_ID;

extern const char *DEVICE_MANUFACTURER;
extern const char *DEVICE_NAME;
extern const char *DEVICE_MODEL;

#define CHECK(x) \
    do { \
        esp_err_t __; \
        if ((__ = (x)) != ESP_OK) \
            return __; \
    } while (0)

#define CHECK_ARG(VAL) \
    do { \
        if (!(VAL)) \
            return ESP_ERR_INVALID_ARG; \
    } while (0)

#define CHECK_LOGE(x, msg, ...) \
    do { \
        esp_err_t __; \
        if ((__ = (x)) != ESP_OK) { \
            ESP_LOGE(TAG, msg, ## __VA_ARGS__); \
            return __; \
        } \
    } while (0)

#define CHECK_LOGW(x, msg, ...) \
    do { \
        esp_err_t __; \
        if ((__ = (x)) != ESP_OK) { \
            ESP_LOGW(TAG, msg, ## __VA_ARGS__); \
        } \
    } while (0)

#define __STR(x) #x
#define STR(x) __STR(x)

#endif // ESP_IOT_NODE_PLUS_COMMON_H_
