MoonshineAgency/joint/(commit log)

2022-01-03 fix warnings
    [partitions.csv]
2022-06-23 moved to c++, add driver concept, first working proto
2022-06-23 fix drivers initialization in node, add const parameters to Kconfig
    [driver.h]
2022-06-29 GH IO driver, GH ADC driver
2022-07-04 GH IO PH driver, RTC, SNMP client
2022-07-04 fix topics for aht and ds18x20
    [drv_aht.c, drv_ds18x20.c]
2022-07-10 driver config, fix wifi settings bug etc
    [api.c, driver.c, driver.h, drv_aht.c, drv_ds18x20.c, drv_gh_adc.c, drv_gh_io.c, drv_ph_meter.c]
2022-07-18 add devices; add mqtt discovery
2022-07-18 rename drivers
2022-07-19 add driver config by mqtt msg, fix cvector realloc error
    [cvector.h, driver.c, ds18b20.c, node.c]
2022-07-19 fix mqtt resub, fix moisture sensor calc, fix mem leak in node
    [gh_adc.c, mqtt.c, node.c]
2022-07-22 fix DEV_NUMBER, add device info to mqtt discovery
    [common.c, common.h, device.c, device.h, driver.c, gh_io.c, gh_ph_meter.c]
2022-07-29 fix defconfig in drivers, add dht driver
    [device.c, dhtxx.c, dhtxx.h, driver.c, driver.h, ds18b20.c, gh_adc.c, gh_io.c]
2022-08-02 add "expire_after" to sensors, add mqtt client state
2022-08-08 update to latest esp-idf-lib, fix printf() format
    [common.h, device.h, dhtxx.c, driver.c, ds18b20.c, gh_adc.c, gh_io.c, mqtt.c]
2023-03-06 add simpler api, fix UTC+/-, fix drivers
    [ahtxx.h, api.c, config.h, dhtxx.c, dhtxx.h, ds18b20.c, ds18b20.h, gh_adc.c]
2023-03-13 (feat) add target boards, optimize drivers, driver configs
2023-03-14 (feat) script to fast update board settings to dev
2023-06-09 feat: add dimmer driver, add GH-4DEV support, refactor hw_rtc
2023-06-10 add ds3231 rtc, fix dimmer
    [node.c]
2023-06-10 add boards schematics and pcb
    [greenhouse.kicad_pcb, greenhouse.kicad_sch]
2023-06-12 fix: update hw to kicad 7, fix capacitor placement in 4.0dev
    [greenhouse.kicad_pcb, greenhouse.kicad_sch]
2023-06-12 feat: add hw for tds & ph meters
    [greenhouse.kicad_pcb, ph_meter.kicad_pcb, ph_meter.kicad_sch, tds_meter.kicad_pcb, tds_meter.kicad_sch]
2023-06-20 Мелкие правки в железе и диммере
    [greenhouse.kicad_pcb, greenhouse.kicad_sch, ph_meter.kicad_pcb, ph_meter.kicad_sch]
2023-06-26 fix bug in hwrtc, remove dimmer, update esp-idf-lib
    [gh_ph_meter.c, node.c]
2023-06-26 allow drivers without config
2023-07-02 fix boards/drivers conditional build
    [ahtxx.h, dhtxx.c, dhtxx.h, ds18b20.c, ds18b20.h, gh_adc.c, gh_adc.h, gh_io.c]
2023-10-27 move sntp from config to settings, fix settings errors
    [bus.h, config.h, device.c, dhtxx.c, ds18b20.c, gh_3x.h, gh_4dev.h, gh_adc.c]
2023-12-02 fix system time, update gh_io for gh4 board
    [config.h, device.c, gh_3x.h, gh_4dev.h, gh_io.c, main.c, node.c]
2023-12-02 add calibration support to gh_ph_meter, gh_adc, fix settings
    [driver.c, driver.h, gh_adc.c, gh_ph_meter.c, settings.h, std_strings.h]
2023-12-05 fix post states of devices bug
    [device.c, gh_adc.c, gh_io.c, mqtt.c, node.c]
2023-12-05 fix name of moisture sensors
    [gh_adc.c]
2023-12-05 add driver configs description, fix show wifi passwd in console
    [ahtxx.h, api.h, dhtxx.c, dhtxx.h, ds18b20.c, gh_adc.c, gh_adc.h, gh_ph_meter.h]
2023-12-08 add support for si7021-compatible sensors, fix adc tds voltage bug, update settings
    [config.h, gh_3x.h, gh_4dev.h, gh_adc.c, node.c, rht.c, rht.h, settings.c]
2023-12-15 add v4.2 board, add option to disable tds in gh_adc driver
2023-12-16 unify calibration json, remove unused code
2023-12-17 add max driver config length as config option
2024-02-11 update system clock, multiple fixes
    [common.c, gh_3x.h, gh_42.h, gh_4dev.h, main.c]
